AkbarDevop/now-spinning/(commit log)

2026-09-25 Akbar Matrix: open-source release
    64x64 LED picture-disc display for YouTube Music on Mac (Chrome
    extension) and iPhone (Bluetooth AMS). Includes Wi-Fi OTA updates,
    bonded iPhone reconnect, Apple + Deezer cover lookup with generated
    fallback art, tap gestures routed to the playing device, idle clock
    and night mode, and a single ./matrix CLI.
    Claude-Session: https://claude.ai/code/session_012jUr5hwjurm3GCCtWnUcMp
2026-09-25 Rotate assembly photo upright
    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
2026-09-25 Add sound-reactive glow from the onboard mics
    The ES7210 mic ADC feeds a loudness/beat envelope (adaptive noise
    floor, slow attack and release, subtle beat pulses) that lights a soft
    halo and rim around the disc in the cover's color. Strength, mic gain
    and on/off are tunable at runtime via /audio and ./matrix audio.
    Audio and gesture task stacks moved to PSRAM so Wi-Fi, Bluetooth and
    TLS keep enough internal RAM.
    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
    [album_display.ino, audio.cpp, imu.cpp, wireless.cpp, wireless.h]
